bovan101/stitch-drawing-robot/hardware/bill-of-materials.md

# Bill of Materials

| Item | Quantity | Notes |
| --- | ---: | --- |
| Arduino Uno R4 WiFi | 1 | Main controller |
| DollaTek 2WD chassis | 1 | Two-wheel robot platform |
| DC geared motor | 2 | Left and right movement |
| TB6612FNG motor driver | 1 | Dual-motor control |
| VL53L1X / TOF400C sensor | 1 | Front distance measurement |
| LM393 slot encoder module | 2 | Wheel pulse monitoring |
| Encoder code disk | 2 | Mounted to the wheels |
| 4AA battery holder | 1 | Motor power supply |
| Arduino prototyping shield | 1 | Soldered control circuit |
| Fixed pen holder | 1 | Rear drawing mechanism |
| Pen | 1 | Records movement traces |
| Jumper wires and connectors | As required | Sensor, encoder, and motor connections |
